holy36/Mach-do-dung-luong-pin/README.md

# measure battery capacity
Mach do dung luong pin litium 18650
