holy36/Mach-do-dung-luong-pin/(list of files, drawings)

Other design files:
DLDT_Project/DLDT_Project.PrjPcb
DLDT_Project/PCB1.PcbDoc
DLDT_Project/Sheet1.SchDoc
